Dacongan/newton-instrumentation/(list of files, cad)

Other CAD files:
cad/models/NI-01_ventilation_cover.3dm
cad/models/NI-04_motor_pulley.3dm
cad/models/NI-04_motor_pulley_sheet.3dm
cad/models/NI-06_solar_cap.3dm
cad/models/NI-07_bahtinov_mask.3dm
cad/models/NI-08_focuser_dust_cap.3dm
