Dacongan/newton-instrumentation/cad/drawings/NI-03_focus_wheel.pdf

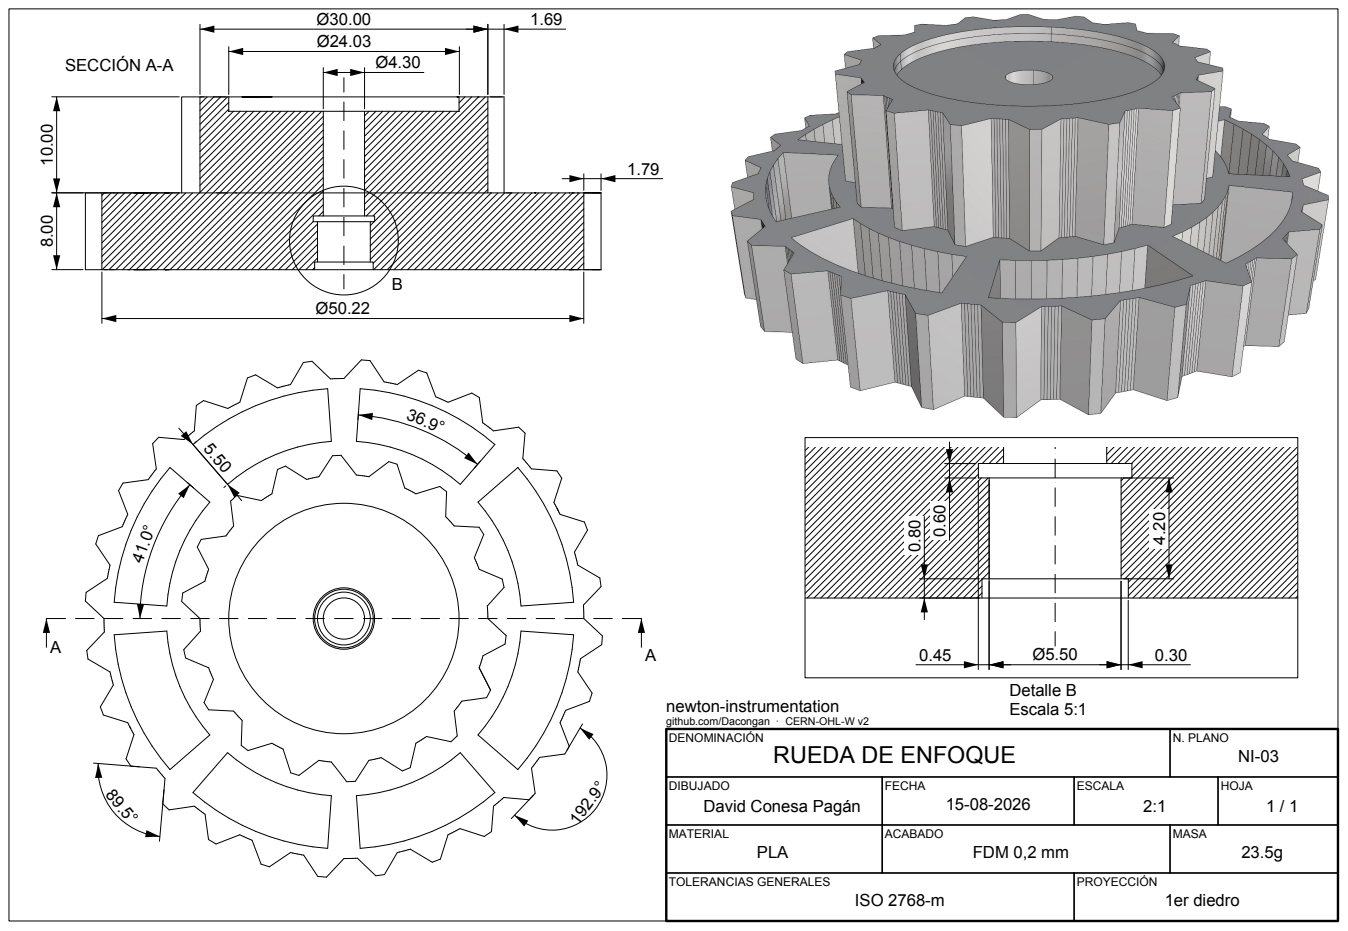
[picture p1: page 1]
PLA; ESCALA; MATERIAL; DIBUJADO; FECHA; HOJA; MASA; TOLERANCIAS GENERALES; N. PLANO; PROYECCIÓN; ACABADO; ISO 2768-m; 1er diedro; FDM 0,2 mm; SECCIÓN A-A; Detalle B Escala 5:1

newton-instrumentation
github.com/Dacongan · CERN-OHL-W v2
DENOMINACIÓN

RUEDA DE ENFOQUE

David Conesa Pagán
