Dacongan/newton-instrumentation/cad/drawings/NI-01_ventilation_cover.pdf

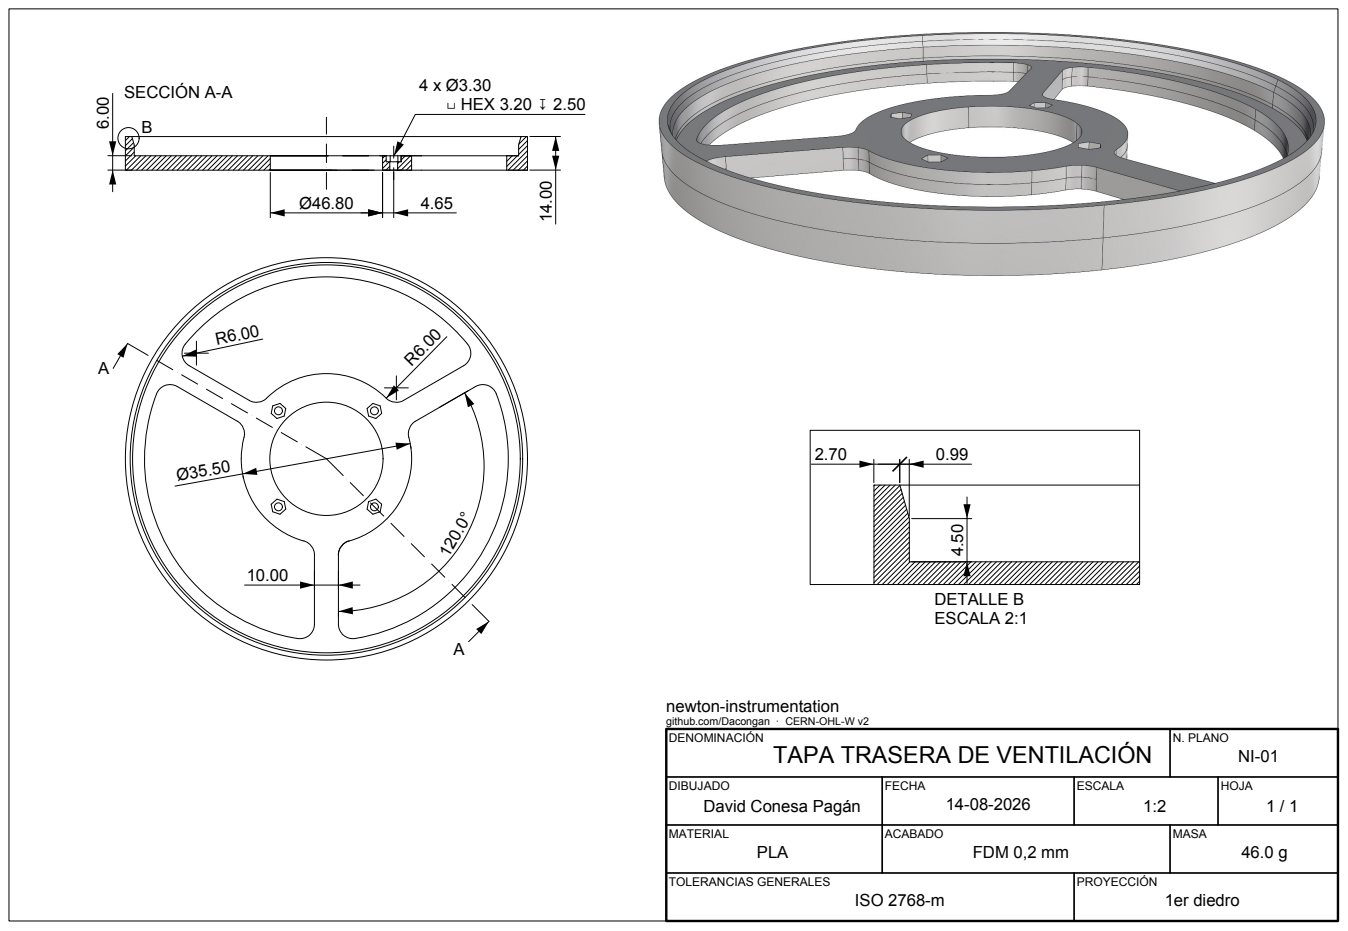
[picture p2: page 1]
ESCALA; PROYECCIÓN; MASA; MATERIAL; 1er diedro; TOLERANCIAS GENERALES; PLA; HOJA; FECHA; N. PLANO; FDM 0,2 mm; ACABADO; ISO 2768-m; SECCIÓN A-A; 4 x Ø3.30 ⌴ HEX 3.20 ↧ 2.50; DETALLE B ESCALA 2:1

newton-instrumentation
github.com/Dacongan · CERN-OHL-W v2
DENOMINACIÓN

TAPA TRASERA DE VENTILACIÓN

DIBUJADO
David Conesa Pagán
