Dacongan/newton-instrumentation/cad/drawings/NI-08_focuser_dust_cap.pdf

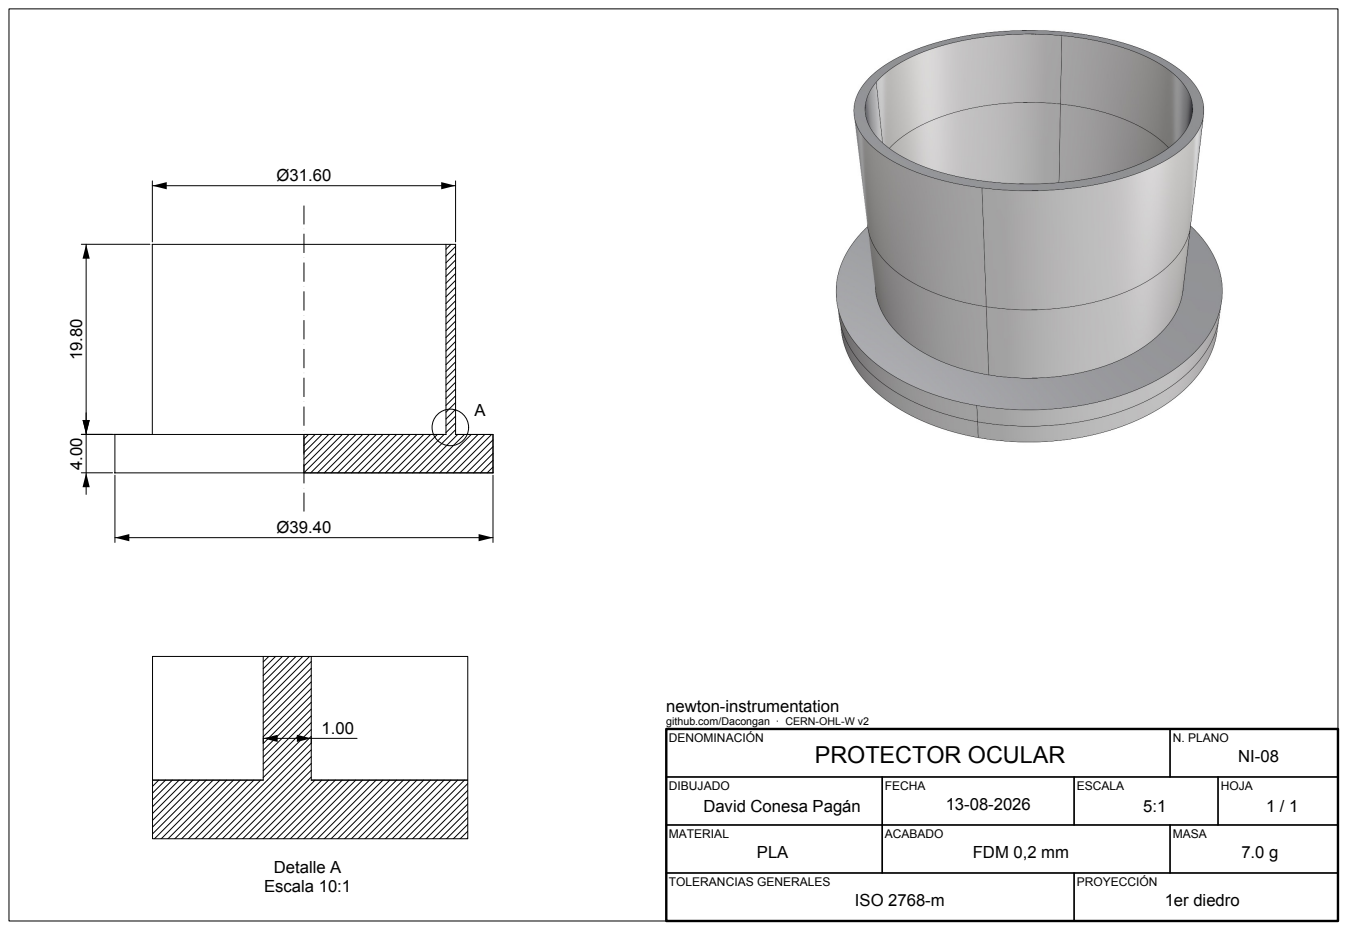
[picture p3: page 1]
PLA; FECHA; MASA; DIBUJADO; TOLERANCIAS GENERALES; PROYECCIÓN; ACABADO; MATERIAL; David Conesa Pagán; HOJA; FDM 0,2 mm; ESCALA; PROTECTOR OCULAR; N. PLANO; ISO 2768-m; 1er diedro; Detalle A Escala 10:1

newton-instrumentation
github.com/Dacongan · CERN-OHL-W v2
DENOMINACIÓN
