Dacongan/newton-instrumentation/cad/drawings/NI-04_motor_pulley.pdf

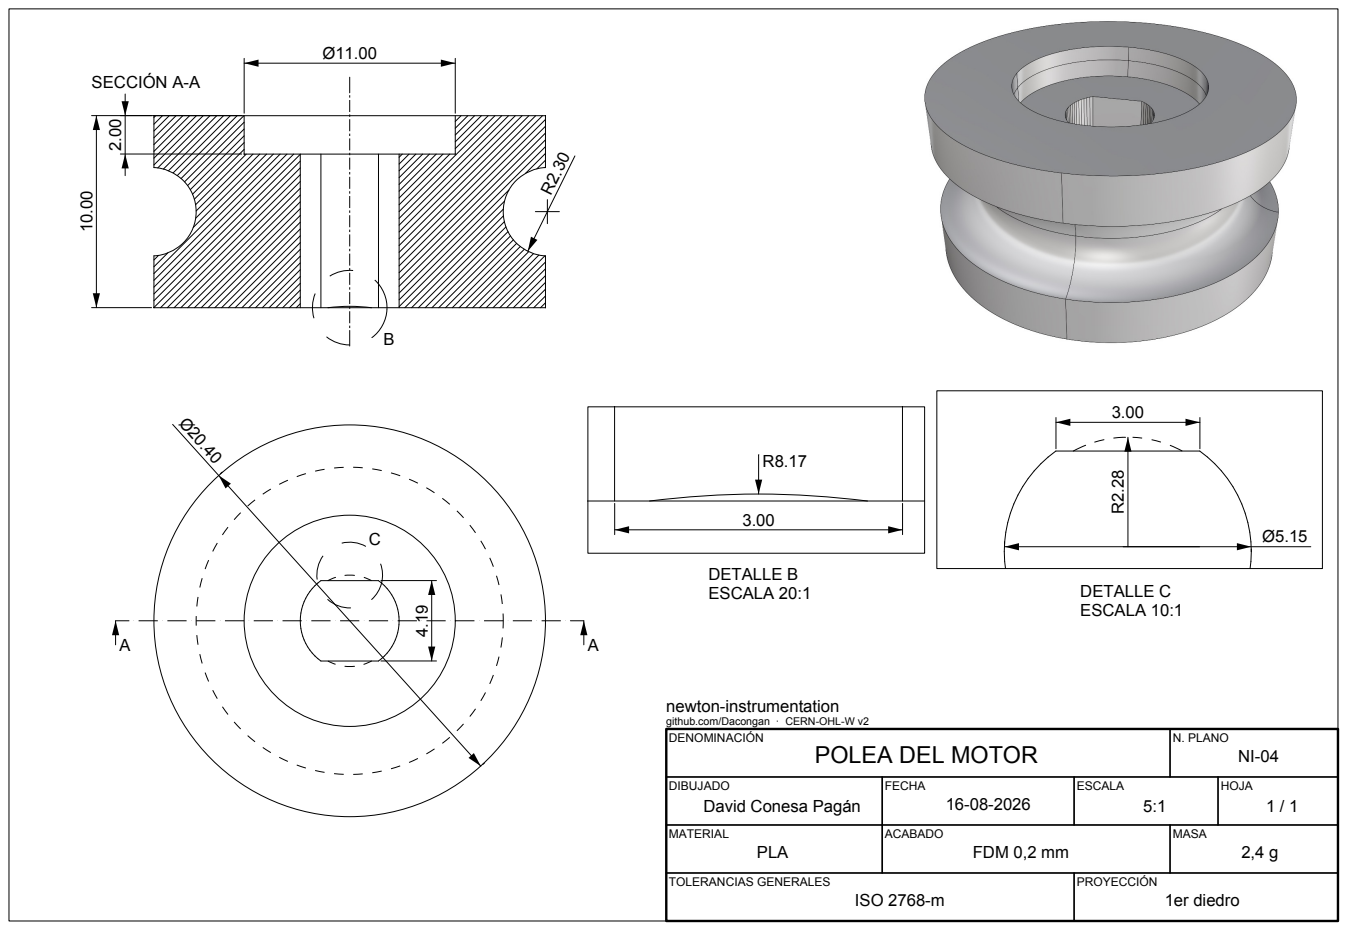
[picture p4: page 1]
N. PLANO; ISO 2768-m; ACABADO; FECHA; TOLERANCIAS GENERALES; ESCALA; MASA; FDM 0,2 mm; PROYECCIÓN; 1er diedro; PLA; HOJA; MATERIAL; DETALLE B ESCALA 20:1; DETALLE C ESCALA 10:1; SECCIÓN A-A

newton-instrumentation
github.com/Dacongan · CERN-OHL-W v2
DENOMINACIÓN

POLEA DEL MOTOR

DIBUJADO
David Conesa Pagán
