Dacongan/newton-instrumentation/(commit log)

2026-08-17 Add parametric CAD sources, Rhino models and drawings
    [NI-01_ventilation_cover.3dm, NI-04_motor_pulley.3dm, NI-04_motor_pulley_sheet.3dm, NI-06_solar_cap.3dm, NI-07_bahtinov_mask.3dm, NI-08_focuser_dust_cap.3dm]
2026-08-17 Add bill of materials and wiring notes
    [bom.csv]
2026-08-18 Add dimensioned drawing for NI-03
    Main views at 2:1, insert seat detail at 5:1. Title block mass is
    the solid volume times PLA density (18.98 cm3 x 1.24 = 23.5 g),
    not the sliced weight: the drawing describes the part, and infill
    is a manufacturing parameter already recorded in cad/parts.md.
2026-08-18 Add NI-03 drawing, PETG print profile and mass convention
    Drawing for NI-03: main views 2:1, insert seat detail 5:1.
    PETG profile for the CR-10 V2 in docs/printing-petg.md, written for
    the NI-06 solar cap set. Layer heights are forced by the geometry of
    the retaining ring: 0.30 + 16 x 0.20 lands both the 3.5 mm total
    height and the 0.9 mm floor under the M3 nuts on exact layer
    boundaries. Glue stick or hairspray is a release layer, not an
    adhesive: PETG welds to glass and takes a chip out on removal.
    Corrects the retraction advice in design-notes.md section 6 - on a
    Bowden, lower the speed rather than raise the distance.
    NI-06.1 goes to 100 % infill. It is a bolted clam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
