Dacongan/newton-instrumentation/(notices)

Notices in the files:
README.md:
Licence: CERN-OHL-W v2
